xiaolong54/wifi-IMU/BOM/淘宝imu+esp32关键元件采购表.xlsx

编号 | 商品名称 | 类型 | 商品链接 | 商家
001 | esp32c3主控 | esp32c3主控 | https://item.taobao.com/item.htm?from=cart&id=652929720450&upStreamPrice=1441 | 优信电子
002 | 贴片电阻511k | 贴片电阻511k | https://item.taobao.com/item.htm?from=cart&id=525777943950&skuId=5868390714818&upStreamPrice=88 | 优信电子
003 | 贴片电阻91k | 贴片电阻91k | https://item.taobao.com/item.htm?from=cart&id=525777943950&skuId=5868181930375&upStreamPrice=88 | 优信电子
004 | 6pin 2.54间距排母 | 6pin 2.54间距排母 | https://item.taobao.com/item.htm?from=cart&id=522579376259&skuId=6139961763387&upStreamPrice=110 | 优信电子
005 | ME4054BM5G | ME4054BM5G | https://item.taobao.com/item.htm?from=cart&id=822262362239&upStreamPrice=17 | 优信电子
006 | SMAJ5.0CA | SMAJ5.0CA | https://item.taobao.com/item.htm?from=cart&id=564793344053&upStreamPrice=220 | 优信电子
007 | 2*4*3.5_侧按贴片2脚_散装(20只) | 2*4*3.5_侧按贴片2脚_散装(20只) | https://item.taobao.com/item.htm?from=cart&id=556985020016&skuId=6133111010370&upStreamPrice=220 | 优信电子
008 | PESD5V0L4UG | PESD5V0L4UG | https://item.taobao.com/item.htm?from=cart&id=695022895464&upStreamPrice=55 | 优信电子
009 | 22uf 0603电容 | 22uf 0603电容 | https://item.taobao.com/item.htm?from=cart&id=537669338432&skuId=5720849848393&upStreamPrice=330 | 优信电子
010 | 1PS76SB10 | 1PS76SB10 | https://item.taobao.com/item.htm?from=cart&id=695809099385&upStreamPrice=15 | 优信电子
011 | 原装TPS631000DRLR SOT-5X3-8 1.5A输出电流高功率降压升压转换器 | buck boost电路 | https://item.taobao.com/item.htm?from=cart&id=868459606745&upStreamPrice=225 | 优信电子
012 | 原装正品 LM66100DCKR SC-70-6 低IQ理想二极管芯片 | 理想二极管 | https://item.taobao.com/item.htm?from=cart&id=765023227888&upStreamPrice=81 | 优信电子
013 | 0806贴片一体成型大电流电感 2016 1UH 0.22/0.47/2.2/3.3/4.7UH | 0806 1UH 4.2A 10个 | https://item.taobao.com/item.htm?from=cart&id=838271867092&skuId=5598753568326&upStreamPrice=330 | HK集科电子元件商城
014 | 无人机电池航模四轴飞行器直升机遥控飞机锂电池3.7v大容量通用1s | 903048-1100毫安 厂家直销 | https://item.taobao.com/item.htm?from=cart&id=578526357216&skuId=4847284198845&upStreamPrice=2250 | 东莞市丹顶鹤电源有限公司
015 | USB Type-C 16P母座卧贴四脚全贴高清传输接口快充插座USB连接器 | Type-C/16P/贴片/有柱 | https://item.taobao.com/item.htm?id=737608633825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 | 优信电子
016 | UMW AO3400A SOT-23 30V/5.8A N沟道 MOS(场效应管)芯片 | NMOS | https://item.taobao.com/item.htm?from=cart&id=654070491207&upStreamPrice=15 | 优信电子
017 | 原装ICM-20948 QFN-24 9轴运动传感器 三轴陀螺仪 加速度计 罗盘 | IMU | https://item.taobao.com/item.htm?from=cart&id=712364558870&upStreamPrice=4510 | 优信电子
018 | ME6211A18M3G-N SOT-23 1.8V 高PSRR低噪声高速LDO线性稳压器 | LDO | https://item.taobao.com/item.htm?from=cart&id=822737707314&upStreamPrice=19 | 优信电子
019 | 单/双 排针 2.54MM 间距 1*40 2*40P 直针 弯针 贴片 长排针 特殊 | 单排直针 2.54 铜 | https://item.taobao.com/item.htm?id=554019811562&skuId=3571916978089 | 优信电子
