xiaolong54/wifi-IMU/3D打印文件/batteryBoxNew-Body001.step

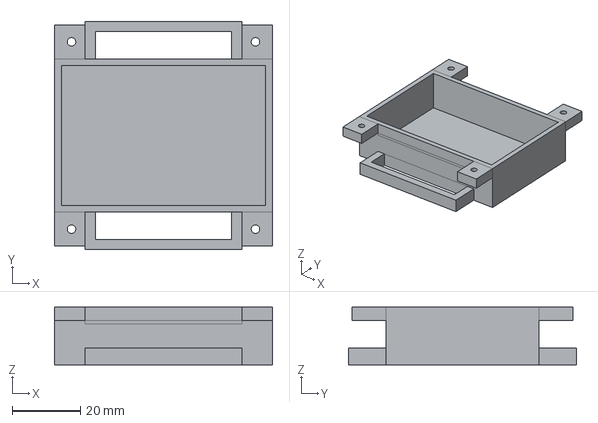
[picture p4: CAD file, 2026-10-29]
3D打印文件/batteryBoxNew-Body001.step
64.0 x 67.0 x 17.0 mm
