xiaolong54/wifi-IMU/3D打印文件/connter-Body.step

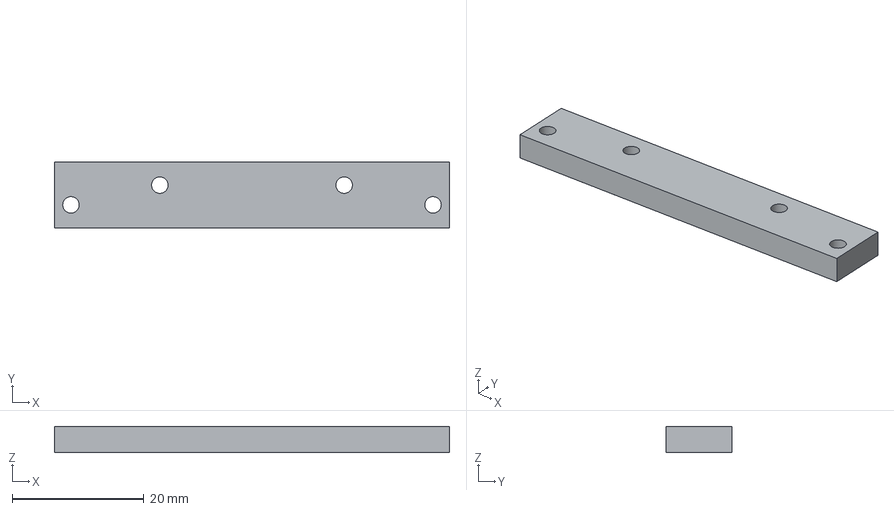
[picture p5: CAD file, 2026-10-29]
3D打印文件/connter-Body.step
60.0 x 10.0 x 4.00 mm
