xiaolong54/wifi-IMU/(commit log)

2026-10-29 Initial commit: Wireless IMU 项目（ESP32-C3 固件 + 硬件 + 上位机）
    - ESP32-C3 + ICM-20948 无线九轴 IMU 固件（VQF 融合 / WiFi UDP / OTA）
    - 立创 EDA 硬件设计文件、BOM、3D 打印外壳、实测数据
    - Python 多 IMU 实时姿态可视化 Dashboard
2026-10-29 docs: 重写 README，梳理结构与排版
    - 新增徽章栏、核心规格速览、目录导航与「快速开始」三步流程
    - 项目结构树重排并补全模块职责说明
    - 特性、传感器、协议通道等内容统一为表格形式
    - 新增「配套文档」索引，串联 PROTOCOL / API / 引脚 / 测试数据
    - 修正固件版本号 v1.4.0 -> v1.2.5（以 CMakeLists PROJECT_VER 为准）
    - 修正 USE_MAGNETOMETER 说明（仅对 LSM9DS1 生效）
    - 标题去除 emoji，锚点链接全部校验通过
