xiaolong54/wifi-IMU/(notices)

Notices in the files:
README.md:
License: Mixed
